jbmorch/SoccerWall/Inovance_docs/readme_docs.md

#Inovance documentation

The PDFs are copies of the official English-language documentation for the Inovance SV660P Servo Driver.

The documents that have "OCR" in their names are excerpts of the larger documents, and can be used to, 
for example, upload to an LLM for help with troubleshooting drive problems.
