jbmorch/SoccerWall/WiringDiagrams.pptx

Soccer Wall

Wiring & Architecture Diagrams

April 2026 — Reference Document

## Slide 2

System Architecture — Control & Signal Path

User Device

Any phone/tablet/laptop
with a browser

SV660P Drive 1

Slave Address: 1

Motor 1 + Brake

MS1H4-40B30CB

Linear Actuator 1

Left side of frame

WiFi

SOCCER_WALL / 192.168.4.1

ESP32

Web Server (192.168.4.1)
+ Modbus RTU Master

RS-485 Bus
(Modbus RTU
57,600 baud)

Ethernet
CN4 → CN3

UART2

MAX485 Module

RS-485 Level Converter

SV660P Drive 2

Slave Address: 2

Motor 2 + Brake

MS1H4-40B30CB

Linear Actuator 2

Right side of frame

POWER SUPPLY OVERVIEW (wiring detail on slides 3 & 4)

24V Battery

TechCella
CAP-TC24100-NW

Y&H Inverter

RS-3200W
24V DC → 120V AC

Buck Converter

24V → 5V
for ESP32 logic

Brake Supply

24V wall wart
for motor brakes

Frame / Structure

~6×6 ft, ~90 lb

## Slide 3

AC Power Distribution — Inverter to Servo Drives

Y&H Inverter (RS-3200W)

BATTERY INPUT

AC OUTPUT

SV660P Drive 1 (Slave Addr: 1)

AC INPUT

BATT+

BATT−

L1

L2

L

AC OUT

WAGO

PE

N

WAGO

SV660P Drive 2 (Slave Addr: 2)

AC INPUT

L1

⏚

WAGO

L2

PE

Wire Colors:

Brown — L (Line)

Blue — N (Neutral)

Wago lever connectors provide 3-way junction for each conductor (inverter + 2 drives).

Green/Yellow — PE (Protective Earth)

## Slide 4

DC Power & Brake Wiring

A — Battery DC Input to Inverter

24V Battery

TechCella
CAP-TC24100-NW

Y&H Inverter (RS-3200W)

DC INPUT

Wire Colors:

BATTERY +

(red circle / white plus)

24V +

DC +

Red — 24V DC+

Black — 24V DC−

BATTERY −

DC −

Brown — Brake+ (no polarity on coil)

Blue — Brake− (no polarity on coil)

Green/Yellow — PE

(white circle / black minus)

24V −

Buck Converter

24V → 5V for ESP32 logic power

(tapped from 24V battery bus)

24V IN

5V OUT →

B — Brake Power Supply to Motor Brakes

Brake Power Supply

24V wall wart
(independent from inverter)

stripped cable,
no connector

Motor 1 — Brake Connector

(brown wire, ferrule)

(blue wire, ferrule)

Brown

WAGO

BRAKE +

BRAKE −

Blue

WAGO

→ PE / chassis ground

Motor 2 — Brake Connector

(brown wire, ferrule)

(blue wire, ferrule)

G/Y

BRAKE +

BRAKE −

## Slide 5

RS-485 Communications — Pin-Level Wiring Detail

SV660P Drive 1

CN3

Pin 4 A

Pin 5 B

Pin 8 GND

SV660P Drive 2

CN3

ESP32

Microcontroller

MAX485 Module

RS-485 Level Converter

GPIO 17
(UART2 TX)

DI

A

Assembled patch cable (RJ45 plug → CN3 socket)

Pin 4 A

GPIO 16
(UART2 RX)

RO

GPIO 4
(DE / RE)

DE

B

Pin 5 B

DE+RE
bridged

RE

GND

GND

GND

Pin 8 GND

CN4

CN3 and CN4 are internally
tied (pins physically shorted)

Wire Colors:

RJ45 pin numbering: 1–8 left-to-right looking at the connector face (tab down).
CN3 and CN4 are internally shorted on the SV660P — CN4 is a pass-through that daisy-chains the bus to the next drive.

Straight-through
Ethernet cable

Green — UART2 TX (ESP32 → MAX485 DI)

Orange — UART2 RX / RS-485 A (RO out / A line)

Purple — DE/RE control / RS-485 B line

Black — Common GND

Blue — Ethernet daisy-chain (CN4 → CN3)
